chisatohojo/hotcake/docs/references/sequence-notes.jpg

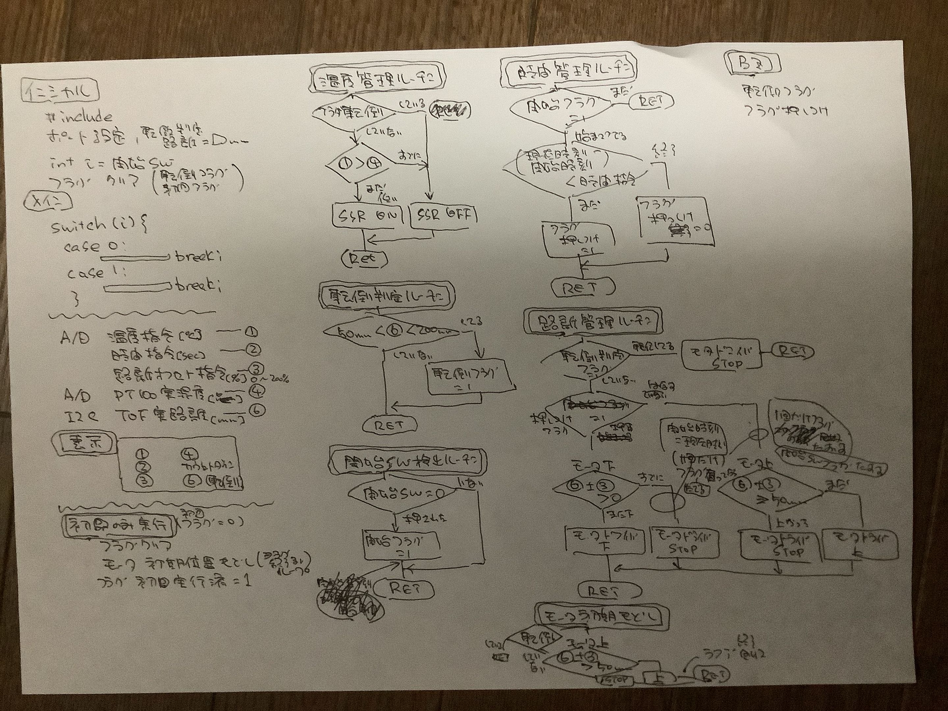
docs/references/sequence-notes.jpg
