chisatohojo/hotcake/docs/references/mega-pin-notes.webp

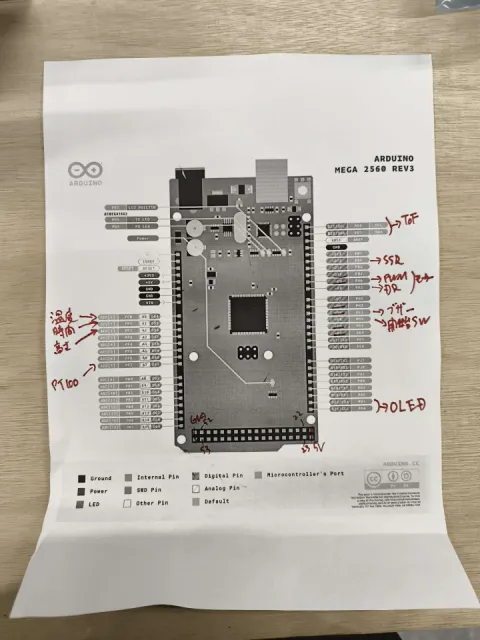
docs/references/mega-pin-notes.webp
