chisatohojo/hotcake/(list of files, cad)

Other CAD files:
cad/焼き印マシーンステー.f3d
