chisatohojo/hotcake/dorayaki_io_check/config.h

#pragma once

#include <Arduino.h>

// -----------------------------------------------------------------------------
// Pin assignment (Arduino Mega 2560 Rev3)
// -----------------------------------------------------------------------------
constexpr uint8_t PIN_POT_TEMP = A0;
constexpr uint8_t PIN_POT_PRESS_TIME = A1;
constexpr uint8_t PIN_POT_HEIGHT = A2;
constexpr uint8_t PIN_PT100 = A7;

constexpr uint8_t PIN_SSR_HOTPLATE = 2;  // HIGH=ON assumed; polarity unverified. Phase 1: LOW only.
constexpr uint8_t PIN_START_SWITCH = 4;  // Internal pull-up: released=HIGH, pressed=LOW
constexpr uint8_t PIN_BUZZER = 5;
constexpr uint8_t PIN_MOTOR_DIR = 8;
constexpr uint8_t PIN_MOTOR_PWM = 9;
constexpr uint8_t PIN_SSR = 12;

// SSR control is disabled until input polarity, electrical compatibility, and
// load ratings are confirmed on the actual hardware. HIGH=ON is provisional.
constexpr bool ENABLE_HOTPLATE_SSR = true;
constexpr bool ENABLE_IMPRINT_SSR = true;

// Mega 2560 hardware I2C pins are fixed at SDA=D20 and SCL=D21.
constexpr uint8_t OLED_I2C_ADDRESS = 0x3C;
constexpr uint8_t TOF_I2C_ADDRESS = 0x29;
constexpr uint8_t OLED_WIDTH = 128;
constexpr uint8_t OLED_HEIGHT = 64;
constexpr int8_t OLED_RESET_PIN = -1;

// Shared bus comparison: change only this value to 100000UL for the 100 kHz trial.
constexpr uint32_t I2C_CLOCK_HZ = 400000UL;
static_assert(I2C_CLOCK_HZ == 100000UL || I2C_CLOCK_HZ == 400000UL,
              "Use 100 kHz or 400 kHz for the I2C comparison");

// Project standard: RIT disabled; keep all other DEFAULT ranging settings.
// Adopted on 2026-10-28. Shared I2C remains at 400 kHz.
constexpr bool TOF_RIT_ENABLED = false;
constexpr float TOF_LIMIT_FIXED_SCALE = 65536.0F;  // Unsigned 16.16 limits -> stated units

// Automatic cycle enabled by user instruction; a new start-switch press is required.
// No jog/test mode or heater control here.
constexpr bool ACTUATOR_SETUP_CONFIRMED = true;
constexpr uint8_t MOTOR_PWM_RUN = 255;  // Duty 100 percent
constexpr uint8_t MOTOR_DIR_UP_LEVEL = HIGH;  // Confirmed: HIGH=up, LOW=down
constexpr uint8_t MOTOR_DIR_DOWN_LEVEL = MOTOR_DIR_UP_LEVEL == HIGH ? LOW : HIGH;
constexpr uint16_t ACTUATOR_UPPER_MM = 250;
constexpr uint16_t ACTUATOR_LOWER_MIN_MM = 50;  // Provisional; adjust to actual limits
static_assert(ACTUATOR_LOWER_MIN_MM > 0 && ACTUATOR_LOWER_MIN_MM < ACTUATOR_UPPER_MM,
              "Lower limit must be positive and below the upper stop");
static_assert(MOTOR_DIR_UP_LEVEL == LOW || MOTOR_DIR_UP_LEVEL == HIGH,
              "DIR level must be LOW or HIGH");

// ST API data formats, not ranging/quality settings.
constexpr float TOF_RATE_FIXED_SCALE = 65536.0F;  // Unsigned 16.16 -> MCPS
constexpr float TOF_SPAD_FIXED_SCALE = 256.0F;    // Unsigned 8.8 -> effective SPADs
constexpr uint8_t TOF_COMMAND_BYTES_PER_LOOP = 8;

// -----------------------------------------------------------------------------
// Timing
// -----------------------------------------------------------------------------
constexpr unsigned long SENSOR_INTERVAL_MS = 100;
constexpr unsigned long TOF_FILTER_TIME_CONSTANT_MS = 1000;
constexpr unsigned long DISPLAY_INTERVAL_MS = 250;
constexpr unsigned long SERIAL_INTERVAL_MS = 1000;
constexpr unsigned long SWITCH_DEBOUNCE_MS = 30;
constexpr unsigned long START_BEEP_MS = 100;

// -----------------------------------------------------------------------------
// Analog setting ranges and smoothing
// -----------------------------------------------------------------------------
constexpr float TEMP_SET_MIN_C = 150.0F;
constexpr float TEMP_SET_MAX_C = 300.0F;
constexpr float PRESS_TIME_MIN_S = 1.0F;
constexpr float PRESS_TIME_MAX_S = 10.0F;
constexpr float HEIGHT_SET_MIN_MM = 0.0F;
constexpr float HEIGHT_SET_MAX_MM = 300.0F;

// Exponential moving average: larger value reacts faster, smaller value is smoother.
constexpr float ANALOG_FILTER_ALPHA = 0.20F;

// -----------------------------------------------------------------------------
// PT100 conversion/calibration
// Circuit: 5V -- series resistor -- A7 -- PT100 -- GND
// Rpt100 = series_resistor * ADC / (1023 - ADC)
// -----------------------------------------------------------------------------
constexpr float PT100_SERIES_RESISTOR_OHM = 1000.0F; // Actual divider resistor: 1 kOhm
constexpr float PT100_R0_OHM = 100.0F;
constexpr float PT100_CVD_A = 3.9083e-3F;
constexpr float PT100_CVD_B = -5.775e-7F;
constexpr float PT100_CAL_GAIN = 1.0F;      // Future span calibration
constexpr float PT100_CAL_OFFSET_C = 0.0F; // Future zero calibration
constexpr float PT100_MIN_C = 0.0F;
constexpr float PT100_MAX_C = 850.0F;

// Guard bands keep the divider calculation away from zero and full-scale faults.
constexpr uint16_t PT100_ADC_MIN_VALID = 1;
constexpr uint16_t PT100_ADC_MAX_VALID = 1022;

// -----------------------------------------------------------------------------
// Buzzer behavior
// Current implementation assumes an active buzzer: HIGH=ON, LOW=OFF.
// Change setBuzzerOutput() if a passive or active-low buzzer is selected later.
// -----------------------------------------------------------------------------
constexpr uint8_t BUZZER_ON_LEVEL = HIGH;
constexpr uint8_t BUZZER_OFF_LEVEL = LOW;
