chisatohojo/hotcake/(commit log)

2026-10-07 Fix PT100 divider and make Windows handoff reproducible
    [config.h]
2026-10-07 Record resolved OLED wiring and latest I/O checks
2026-10-14 Enable internal pull-up for the start switch
2026-10-21 Add hotplate SSR pin with phase-one safe outputs
2026-10-21 Add VL53L0X diagnostics and controlled I2C clock comparison
2026-10-28 Add gated MD20A actuator up-down cycle
2026-10-28 Set actuator duty to 100 percent and record confirmed direction
2026-10-28 Enable actuator cycle after user hardware confirmation
2026-10-28 Record enabled actuator firmware upload and idle startup
2026-10-28 Add one-second ToF filter and OLED target display
2026-10-29 Set actuator upper stop to 250mm
